CSpyridakis/MeshNetwork/reports/Images/DSC_0396.JPG

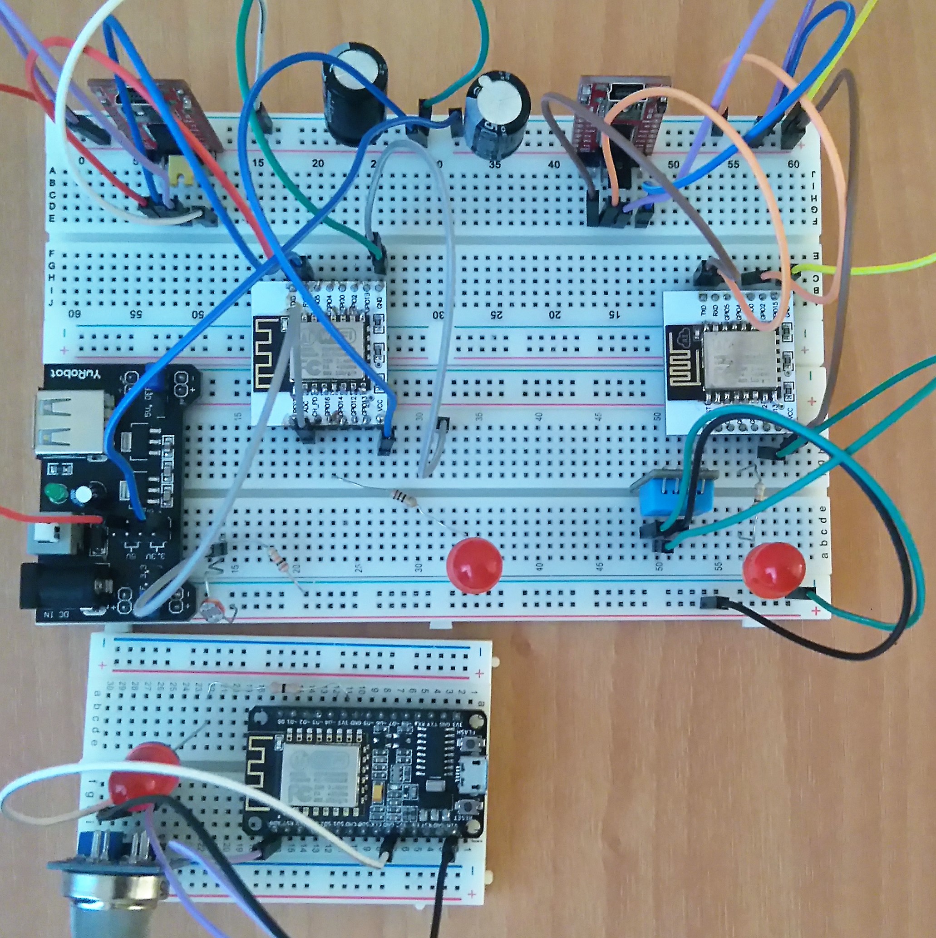
reports/Images/DSC_0396.JPG
