CSpyridakis/MeshNetwork/README.md

[HPY411] Embedded Systems

#Directories

Milestone Reports and Presentation: reports/

Eagle Schematics: Eagle/Embedded/NodeBoard/

Eagle Dependencies: Eagle/dependencies

Arduino / Esp8266 Dependencies: ESP8266_Dependencies/
 
Code: WSN/

Arduino-ESP8266 Dependencies: dependencies/
