CSpyridakis/MeshNetwork/reports/Images/esp8266_power.jpg

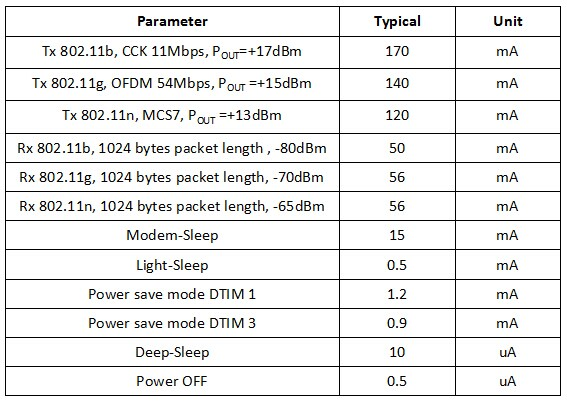
reports/Images/esp8266_power.jpg
