CSpyridakis/MeshNetwork/Eagle/Embedded/NodeBoard/NodeBoard.brd

## EAGLE design Eagle/Embedded/NodeBoard/NodeBoard.brd (2017-12-06)

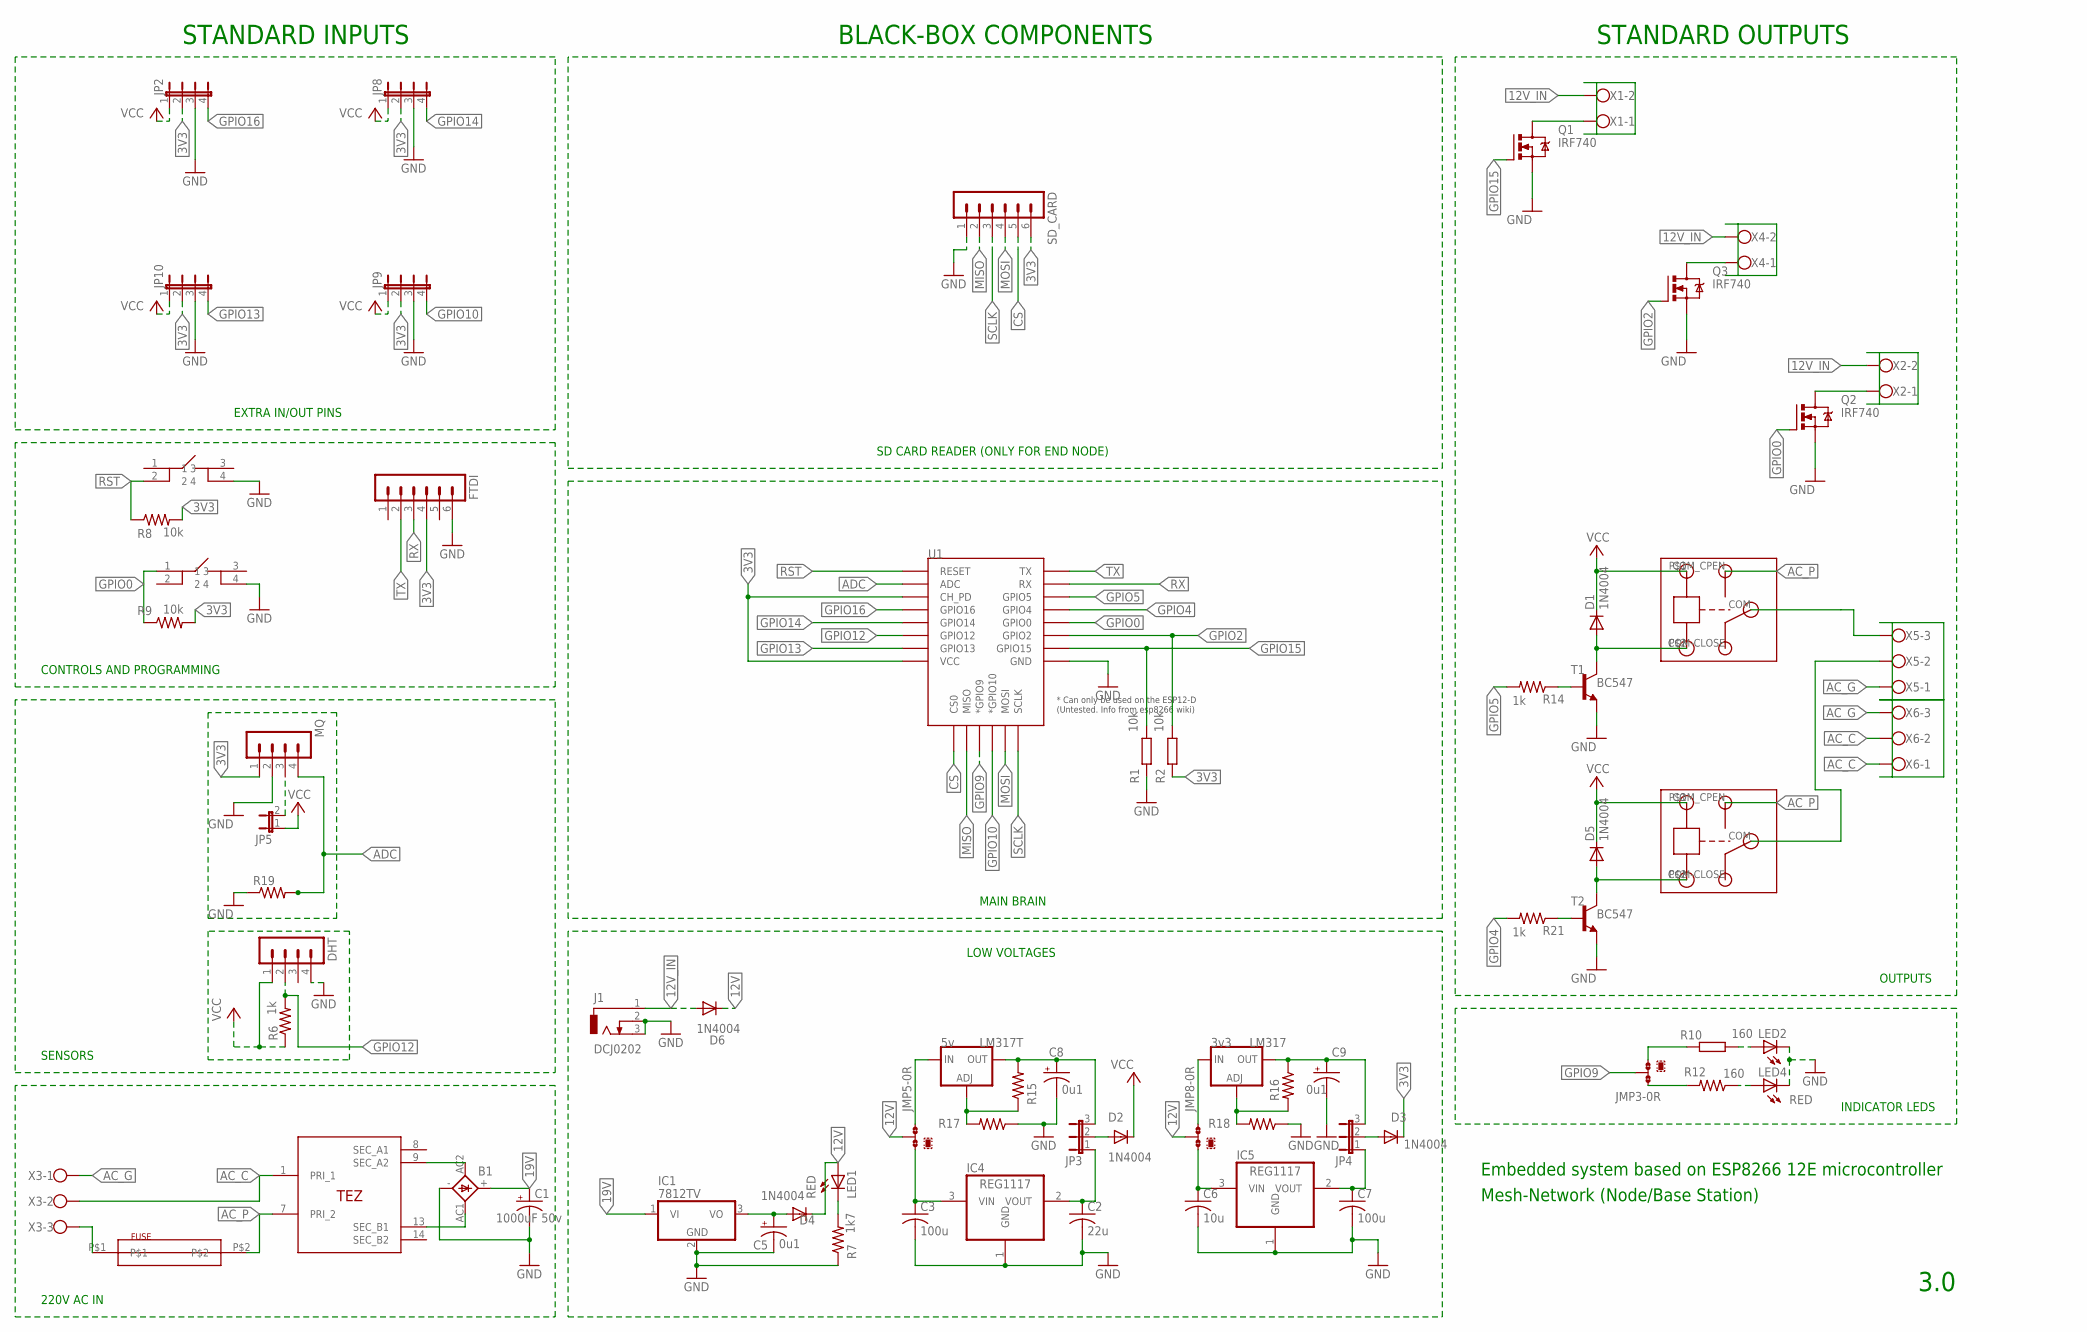
[picture p32: schematic NodeBoard.sch]

Parts:
B1: KBL
C1: 1000uF 50v; E5-13
C2: 22u; C0805
C3, C7: 100u; C0805
C5, C8, C9: 0u1; E2,5-6E
C6: 10u; C0805
D1, D2, D3, D4, D5, D6: 1N4004; DO41-10
DHT: MA04-1
FTDI: MA06-1
IC1: 7812TV; TO220V
IC4, IC5: REG1117; SOT223
J1: DCJ0202
JMP3, JMP5, JMP8: 0R-JUMPA; A0R-JMP
JP2, JP8, JP9, JP10: JP4E; JP4
JP3, JP4: JP2E; JP2
JP5: JP1E; JP1
LED1, LED4: RED; LED5MM
LED2: LEDCHIPLED_1206; CHIPLED_1206
LM317: 3v3; 317TS
LM317T: 5v; 317TS
MQ: MA04-1
Q1, Q2, Q3: IRF740; TO220BV
R1, R2: 10k; R0603
R6, R14, R21: 1k; 0204/7
R7, R16, R18: 1k7; 0204/7
R8, R9: 10k; 0204/7
R10: 160; R0603
R12: 160; 0204/7
R15: 15k; 0204/7
R17: 28k; 0204/7
R19: R-US_0204/7; 0204/7
SD_CARD: MA06-1
T1, T2: BC547; TO92
U1: ESP12ESMD; ESP12E-SMD
U$1, U$4: RELAY
U$2: TEZ_16THROUGH_HOLE; TEZ_16
U$3: FUSE_24X11THROUGH_HOLE; FUSE_24X11
U$5, U$6: TACT_SWITCHTHROUGH_HOLE; TACT_SWITCH_TH
X1, X2, X4: W237-102
X3, X5, X6: W237-103

Connections:
3V3: D3.C, FTDI.4, JP2.2, JP8.2, JP9.2, JP10.2, MQ.1, R2.1, R8.2, R9.2, SD_CARD.6, U1.CH_PD, U1.VCC
12V: D4.C, D6.C, JMP5.2, JMP8.2, LED1.A
12V_IN: D6.A, J1.1, X1.2, X2.2, X4.2
19V: B1.+, C1.+, IC1.1 (VI)
AC_C: U$2.1 (PRI_1), X3.2, X6.1, X6.2
AC_G: X3.1, X5.1, X6.3
AC_P: U$1.COM_CPEN (COM-OPEN), U$2.7 (PRI_2), U$3.P$2, U$4.COM_CPEN (COM-OPEN)
ADC: MQ.4, R19.2, U1.ADC
CS: SD_CARD.5, U1.CS0
GND: B1.-, C1.-, C2.2, C3.2, C5.-, C6.2, C7.2, C8.-, C9.-, DHT.4, FTDI.6, IC1.2 (GND), IC4.1 (GND), IC5.1 (GND), J1.2, J1.3, JP2.3, JP8.3, JP9.3, JP10.3, LED2.C, LED4.K (C), MQ.2, Q1.S, Q2.S, Q3.S, R1.1, R7.1, R17.1, R18.1, R19.1, SD_CARD.1, T1.1 (E), T2.1 (E), U1.GND, U$5.4, U$6.4
GPIO0: Q2.G, R9.1, U1.GPIO0, U$6.1
GPIO2: Q3.G, R2.2, U1.GPIO2
GPIO4: R21.2, U1.GPIO4
GPIO5: R14.2, U1.GPIO5
GPIO9: JMP3.2, U1.GPIO9 (*GPIO9)
GPIO10: JP9.4, U1.GPIO10 (*GPIO10)
GPIO12: DHT.2, R6.2, U1.GPIO12
GPIO13: JP10.4, U1.GPIO13
GPIO14: JP8.4, U1.GPIO14
GPIO15: Q1.G, R1.2, U1.GPIO15
GPIO16: JP2.4, U1.GPIO16
MISO: SD_CARD.2, U1.MISO
MOSI: SD_CARD.4, U1.MOSI
unnamed: B1.AC2 (AC1), U$2.9 (SEC_A2)
unnamed: LED1.K (C), R7.2
unnamed: B1.AC1 (AC2), U$2.13 (SEC_B1)
unnamed: U$1.COM, X5.3
unnamed: JP5.2, MQ.3
unnamed: Q1.D, X1.1
unnamed: Q3.D, X4.1
unnamed: LED2.A, R10.2
unnamed: LED4.A, R12.1
unnamed: JMP3.1, R12.2
unnamed: JMP3.3, R10.1
unnamed: R14.1, T1.2 (B)
unnamed: D1.A, T1.3 (C), U$1.P$2 (GND)
unnamed: R21.1, T2.2 (B)
unnamed: C8.+, JP3.3, LM317T.2 (OUT), R15.2
unnamed: LM317T.1 (ADJ), R15.1, R17.2
unnamed: C9.+, JP4.3, LM317.2 (OUT), R16.1
unnamed: LM317.1 (ADJ), R16.2, R18.2
unnamed: JMP5.3, LM317T.3 (IN)
unnamed: JMP8.3, LM317.3 (IN)
unnamed: D2.A, JP3.2
unnamed: D3.A, JP4.2
unnamed: C5.+, D4.A, IC1.3 (VO)
unnamed: C2.1, IC4.2 (VOUT), JP3.1
unnamed: C6.1, IC5.3 (VIN), JMP8.1
unnamed: C3.1, IC4.3 (VIN), JMP5.1
unnamed: Q2.D, X2.1
unnamed: C7.1, IC5.2 (VOUT), JP4.1
unnamed: D5.A, T2.3 (C), U$4.P$2 (GND)
unnamed: U$3.P$1, X3.3
unnamed: U$4.COM, X5.2
RST: R8.1, U1.RESET, U$5.2
RX: FTDI.3, U1.RXD0 (RX)
SCLK: SD_CARD.3, U1.SCLK
TX: FTDI.2, U1.TXD0 (TX)
VCC: D1.C, D2.C, D5.C, DHT.1, JP2.1, JP5.1, JP8.1, JP9.1, JP10.1, R6.1, U$1.P$1 (IN), U$4.P$1 (IN)

Notes on the sheet:
220V AC IN
CONTROLS AND PROGRAMMING
SENSORS
3.0
Embedded system based on ESP8266 12E microcontroller
LOW VOLTAGES
INDICATOR LEDS
OUTPUTS
Mesh-Network (Node/Base Station)
EXTRA IN/OUT PINS
SD CARD READER (ONLY FOR END NODE)
MAIN BRAIN
STANDARD INPUTS
STANDARD OUTPUTS
BLACK-BOX COMPONENTS

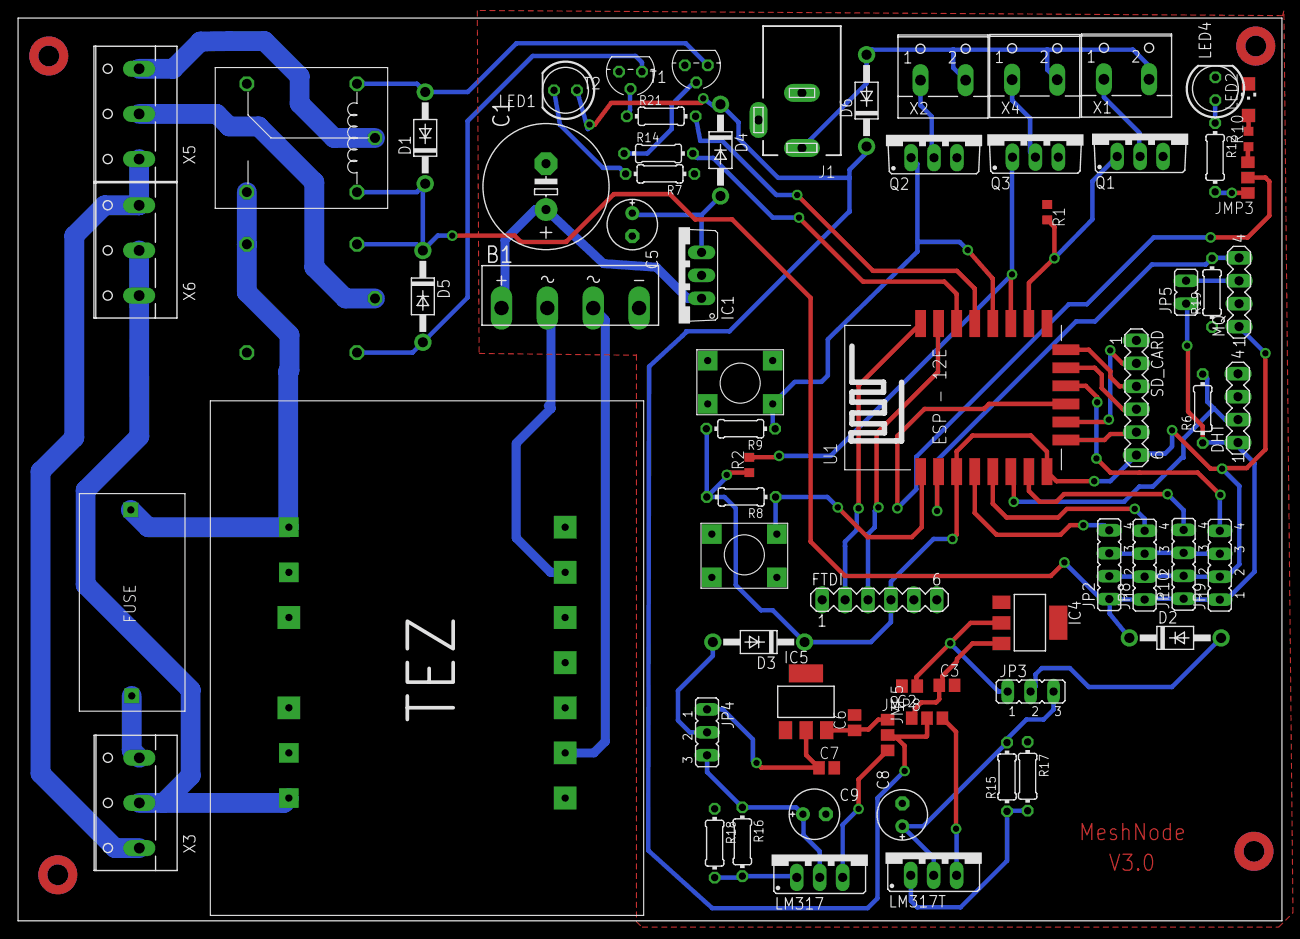
[picture p33: board NodeBoard.brd from above]

Board: 2 copper layers, 140.0 x 100.0 mm, 71 parts (1 on the bottom side), 59 nets.
