CSpyridakis/MeshNetwork/WSN/easyMeshSTA.cpp

#include <Arduino.h>
#include <SimpleList.h>

extern "C" {
    #include "user_interface.h"
    #include "espconn.h"
}

#include "easyMesh.h"

/**
 * A static copy of the mesh handler, kept for convenience.
 */
extern easyMesh* staticThis;

/**
 * Initializes the station and starts the AP scan.
 * Called after init().
 */
void ICACHE_FLASH_ATTR easyMesh::stationInit( void ) {
    debugMsg( STARTUP, "stationInit():\n");
    startStationScan();
    return;
}

/**
 * Refreshes the connection status of the station.
 * Prints useful debug messages.
 */
void ICACHE_FLASH_ATTR easyMesh::manageStation( void ) {
    debugMsg(GENERAL, "manageStation():\n");

    static uint8_t previousStatus;
    uint8_t stationStatus = wifi_station_get_connect_status();

    if (stationStatus != previousStatus) {
        switch (stationStatus) {
            case STATION_IDLE:
                debugMsg(MESH_STATUS, "stationStatus Changed to STATION_IDLE\n");
                break;
            case STATION_CONNECTING:
                debugMsg(MESH_STATUS, "stationStatus Changed to STATION_CONNECTING\n");
                break;

            case STATION_WRONG_PASSWORD:
                debugMsg(MESH_STATUS, "stationStatus Changed to STATION_WRONG_PASSWORD\n");
                break;

            case STATION_NO_AP_FOUND:
                debugMsg(MESH_STATUS, "stationStatus Changed to STATION_NO_AP_FOUND\n");
                break;

            case STATION_CONNECT_FAIL:
                debugMsg(MESH_STATUS, "stationStatus Changed to STATION_CONNECT_FAIL\n");
                break;

            case STATION_GOT_IP:
                debugMsg(MESH_STATUS, "stationStatus Changed to STATION_GOT_IP\n");
                break;

        }
        previousStatus = stationStatus;
    }
}

/**
 * Starts scanning if on station mode.
 * Changes the scan status to SCANNING iff its IDLE.
 */
void ICACHE_FLASH_ATTR easyMesh::startStationScan( void ) {
    debugMsg(GENERAL, "startStationScan():\n");

    if (_scanStatus != IDLE) {
        return;
    }

    if (!wifi_station_scan(NULL, stationScanCb)) {
        debugMsg(ERROR, "wifi_station_scan() failed!?\n");
        return;
    }
    _scanStatus = SCANNING;
    debugMsg(CONNECTION, "-->scan started @ %d<--\n", system_get_time());
    return;
}

/**
 * Starts the station scan.
 * TODO eliminate this function on future releases.
 */
void ICACHE_FLASH_ATTR easyMesh::scanTimerCallback( void *arg ) {
    staticThis->startStationScan();
}

/**
 * Scans for available APs in the area with a matching prefix
 * and then tries to connect to the best one.
 */
void ICACHE_FLASH_ATTR easyMesh::stationScanCb(void *arg, STATUS status) {
    char ssid[32];
    bss_info *bssInfo = (bss_info *) arg;
    staticThis->debugMsg(CONNECTION, "stationScanCb():-- > scan finished @ % d < --\n", system_get_time());
    staticThis->_scanStatus = IDLE;

    staticThis->_meshAPs.clear();
    while (bssInfo != NULL) {
        staticThis->debugMsg(CONNECTION, "\tfound : % s, % ddBm", (char *) bssInfo->ssid, (int16_t) bssInfo->rssi);
        if (strncmp((char *) bssInfo->ssid, staticThis->_meshPrefix.c_str(), staticThis->_meshPrefix.length()) == 0) {
            staticThis->debugMsg(CONNECTION, " MESH_PRE< ---");
            staticThis->_meshAPs.push_back(*bssInfo);
        }
        staticThis->debugMsg(CONNECTION, "\n");
        bssInfo = STAILQ_NEXT(bssInfo, next);
    }
    staticThis->debugMsg(CONNECTION, "\tFound % d nodes with _meshPrefix = \"%s\"\n",
                         staticThis->_meshAPs.size(),
                         staticThis->_meshPrefix.c_str());

    staticThis->connectToBestAP();
}

/**
 * Drop the connected AP (if there is one) and try to find the one with the best signal.
 * If not IDLE this routine will fail. If no nodes are found retry in 5 sec.
 * If at least 1 meshAP exists find the one with the strongest signal  that is not already connected to our AP.
 * Finally drop bestAP from mesh list, so if doesn't work out, we can try the next one.
 */
bool ICACHE_FLASH_ATTR easyMesh::connectToBestAP( void ) {
    debugMsg(CONNECTION, "connectToBestAP():");

    SimpleList<bss_info>::iterator ap = _meshAPs.begin();
    while (ap != _meshAPs.end()) {
        String apChipId = (char *) ap->ssid + _meshPrefix.length();
        if (findConnection(apChipId.toInt()) != NULL) {
            ap = _meshAPs.erase(ap);
        } else {
            ap++;
        }
    }

    uint8 statusCode = wifi_station_get_connect_status();
    if (statusCode != STATION_IDLE) {
        debugMsg(CONNECTION, "connectToBestAP(): station not idle.  code=%d\n", statusCode);
        return false;
    }

    if (staticThis->_meshAPs.empty()) {
        debugMsg(CONNECTION, "connectToBestAP(): no nodes left in list, rescanning\n");
        os_timer_setfn(&_scanTimer, scanTimerCallback, NULL);
        os_timer_arm(&_scanTimer, SCAN_INTERVAL, 0);
        return false;
    }

    _nodeStatus = FOUND_MESH;
    SimpleList<bss_info>::iterator bestAP = staticThis->_meshAPs.begin();
    SimpleList<bss_info>::iterator i = staticThis->_meshAPs.begin();
    while (i != staticThis->_meshAPs.end()) {
        if (i->rssi > bestAP->rssi) {
            bestAP = i;
        }
        ++i;
    }

    debugMsg(CONNECTION, "connectToBestAP(): Best AP is %s<---\n", (char *) bestAP->ssid);
    struct station_config stationConf;
    stationConf.bssid_set = 0;
    memcpy(&stationConf.ssid, bestAP->ssid, 32);
    memcpy(&stationConf.password, _meshPassword.c_str(), 64);
    wifi_station_set_config(&stationConf);
    wifi_station_connect();

    _meshAPs.erase(bestAP);
    return true;
}

/**
 *  Establishes a TCP connection after connecting to a WiFi as a station.
 */
void ICACHE_FLASH_ATTR easyMesh::tcpConnect( void ) {
    debugMsg(GENERAL, "tcpConnect():\n");

    struct ip_info ipconfig;
    wifi_get_ip_info(STATION_IF, &ipconfig);

    if (wifi_station_get_connect_status() == STATION_GOT_IP && ipconfig.ip.addr != 0) {
        debugMsg(CONNECTION, "tcpConnect(): Got local IP=%d.%d.%d.%d\n", IP2STR(&ipconfig.ip));
        debugMsg(CONNECTION, "tcpConnect(): Dest IP=%d.%d.%d.%d\n", IP2STR(&ipconfig.gw));

        _stationConn.type = ESPCONN_TCP;
        _stationConn.state = ESPCONN_NONE;
        _stationConn.proto.tcp = &_stationTcp;
        _stationConn.proto.tcp->local_port = espconn_port();
        _stationConn.proto.tcp->remote_port = _meshPort;
        os_memcpy(_stationConn.proto.tcp->local_ip, &ipconfig.ip, 4);
        os_memcpy(_stationConn.proto.tcp->remote_ip, &ipconfig.gw, 4);
        espconn_set_opt(&_stationConn, ESPCONN_NODELAY); // low latency, but soaks up bandwidth

        debugMsg(CONNECTION,
                 "tcpConnect(): connecting type=%d, state=%d, local_ip=%d.%d.%d.%d, local_port=%d, remote_ip=%d.%d.%d.%d remote_port=%d\n",
                 _stationConn.type,
                 _stationConn.state,
                 IP2STR(_stationConn.proto.tcp->local_ip),
                 _stationConn.proto.tcp->local_port,
                 IP2STR(_stationConn.proto.tcp->remote_ip),
                 _stationConn.proto.tcp->remote_port);

        espconn_regist_connectcb(&_stationConn, meshConnectedCb);
        espconn_regist_recvcb(&_stationConn, meshRecvCb);
        espconn_regist_sentcb(&_stationConn, meshSentCb);
        espconn_regist_reconcb(&_stationConn, meshReconCb);
        espconn_regist_disconcb(&_stationConn, meshDisconCb);

        sint8 errCode = espconn_connect(&_stationConn);
        if (errCode != 0) {
            debugMsg(ERROR, "tcpConnect(): err espconn_connect() falied=%d\n", errCode);
        }
    } else {
        debugMsg(ERROR, "tcpConnect(): err Something un expected in tcpConnect()\n");
    }
}
