CSpyridakis/MeshNetwork/WSN/easyMeshSync.h

#ifndef   _MESH_SYNC_H_
#define   _MESH_SYNC_H_

#include <Arduino.h>

#define SCAN_INTERVAL       10000
#define SYNC_INTERVAL       7000
#define TIME_SYNC_CYCLES    10

class timeSync {
public:
    uint32_t times[TIME_SYNC_CYCLES];
    int8_t num = -1;
    bool adopt;

    String buildTimeStamp(void);

    bool processTimeStamp(String &str);

    void calcAdjustment(bool even);
};

#endif
