CSpyridakis/MeshNetwork/WSN/easyMeshDebug.cpp

#include <Arduino.h>
#include <stdarg.h>

#include "easyMesh.h"

uint16_t types = 0;

/**
 * Set the different kinds of debug messages you want to generate.
 * @param newTypes The mask of allowed debug types:
 * ERROR | MESH_STATUS | CONNECTION | SYNC | COMMUNICATION | GENERAL | MSG_TYPES | REMOTE
 */

void easyMesh::setDebugMsgTypes(uint16_t newTypes) {
    types = newTypes;
    Serial.printf("setDebugTypes 0x%x\n", types);
}

/**
 *
 * @param type The type of the message to be desplayed (see above).
 * @param format The message to be desplayed.
 */
void easyMesh::debugMsg(debugType type, const char *format ...) {
    if (type & types) {  //Print only the message types set for output
        char str[200];

        va_list args;
        va_start(args, format);

        vsnprintf(str, sizeof(str), format, args);

        if (types && MSG_TYPES)
            Serial.printf("0x%x\t", type, types);

        Serial.print(str);

        va_end(args);
    }
}
