CSpyridakis/MeshNetwork/(commit log)

2017-09-26 Added Eagle files
    [module.sch]
2017-09-26 Serial print cmds removed
2017-09-26 Serial print cmds removed3
2017-09-26 Timers OK
2017-09-27 Added all sensors
2017-09-27 All sensors working correctly
    [WSN.ino]
2017-09-27 All sensors are correctly calibrated
    [WSN.ino]
2017-09-27 Experimenting with WatchDog timers...
2017-09-28 Changed timers to os_timer_t
2017-09-28 Fixed a bug with DHT11 low voltage
    [WSN.ino]
2017-09-29 Refactoring.Added an extra timer.Events are produced and consumed on different timers now.
2017-09-29 Trying to fix WiFi connection
    [WSN.ino]
2017-09-29 Refactoring.Added an extra timer.Events are produced and consumed on different timers now.2
2017-09-29 Fixed timer callbacks.Removed interrupts.
    [WSN.ino]
2017-09-30 timer0 and timer1 added
    Hardware timer0 handles all the broadcast related work
2017-10-02 Documentation updated.Main loop() now includes checks for interrupts. Threshold values added in meshConstants.h. Added extra image and example log.
2017-10-02 Documentation updated.Main loop() now includes checks for interrupts. Threshold values added in meshConstants.h. Added extra image and example log. Updated proposal.
2017-10-03 Eagle controls and sensors added
    [controls.sch, module.sch]
2017-10-03 Added relay node option in meshConstants. Migrated the getReadings from the ISR to the main loop() func.
2017-10-03 Fixed initial values on some vars so relay nodes can function properly.
    [WSN.ino]
2017-10-03 Fixed a bug on DHT11, now working without any problems.
    [WSN.ino, meshConstants.h]
2017-10-05 Logs of 4 esp8266 (observed by a relay)
2017-10-27 Eagle files ready for MeshNode
    [NodeBoard.brd, NodeBoard.sch, controls.sch, module.sch]
2017-10-27 Minor Eagle Board fixes
    [NodeBoard.brd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]
2017-10-27 Eagle Flipped directional components
    [NodeBoard.brd, NodeBoard.sch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]
2017-10-27 Eagle via fix
    [NodeBoard.brd]
2017-10-27 Fix dimentions
    [NodeBoard.brd]
2017-10-27 Eagle 121x96 end dimention
    [NodeBoard.brd, NodeBoard.sch]
2017-10-30 Eagle pcb v2.0
    [NodeBoard.brd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]
2017-12-06 Report, and eagle changes
    [NodeBoard.brd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]
